julianvillarreal/CONVERTER-QBOOST/README.md

# CONVERTER-QBOOST

Implementación realizada en la IDE de arduino para se ejecutada en la tarjeta arduino Mega 2560
