julianvillarreal/CONVERTER-QBOOST/PCB/Sensado_V_I_QBoost_v0.1/Sensado_V_I_QBoost_v0.1.pdf

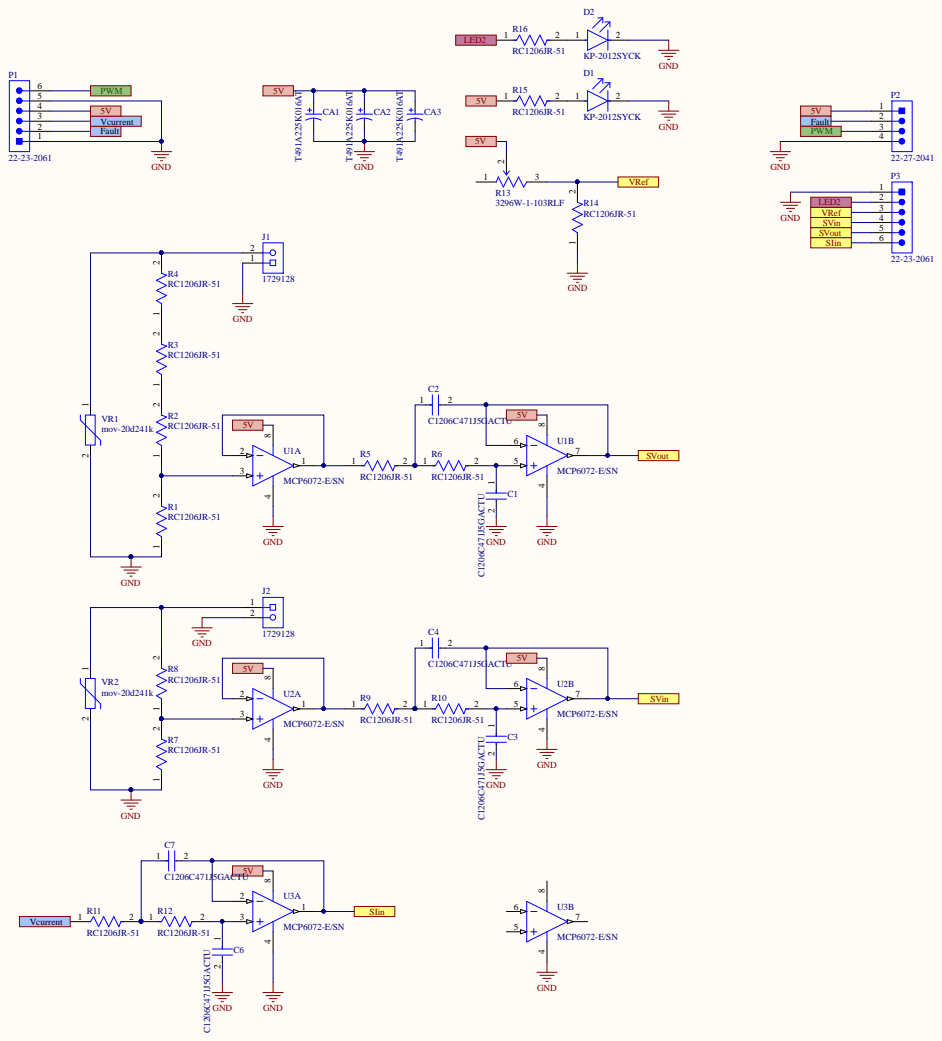
[picture p1: page 1]

Title | Protel International P/L L3, 12a Rodborough Rd NSW Frenchs Forest Australia 2086

Size: A1 | Number: | Revision:

Date: 17/10/2020 Time: 11:50:41 p. m. | | Sheet of

C:\Users\Julian\OneDrive - Pontificia Universidad Javeriana\10 semestre\PG2\PCB QBOOST\PCB 2 - Sensado\Sensado_Vin_Vou_Iin_0.1\Sensado_V_I_QBoost_v0.1\Sensado.SchDoc

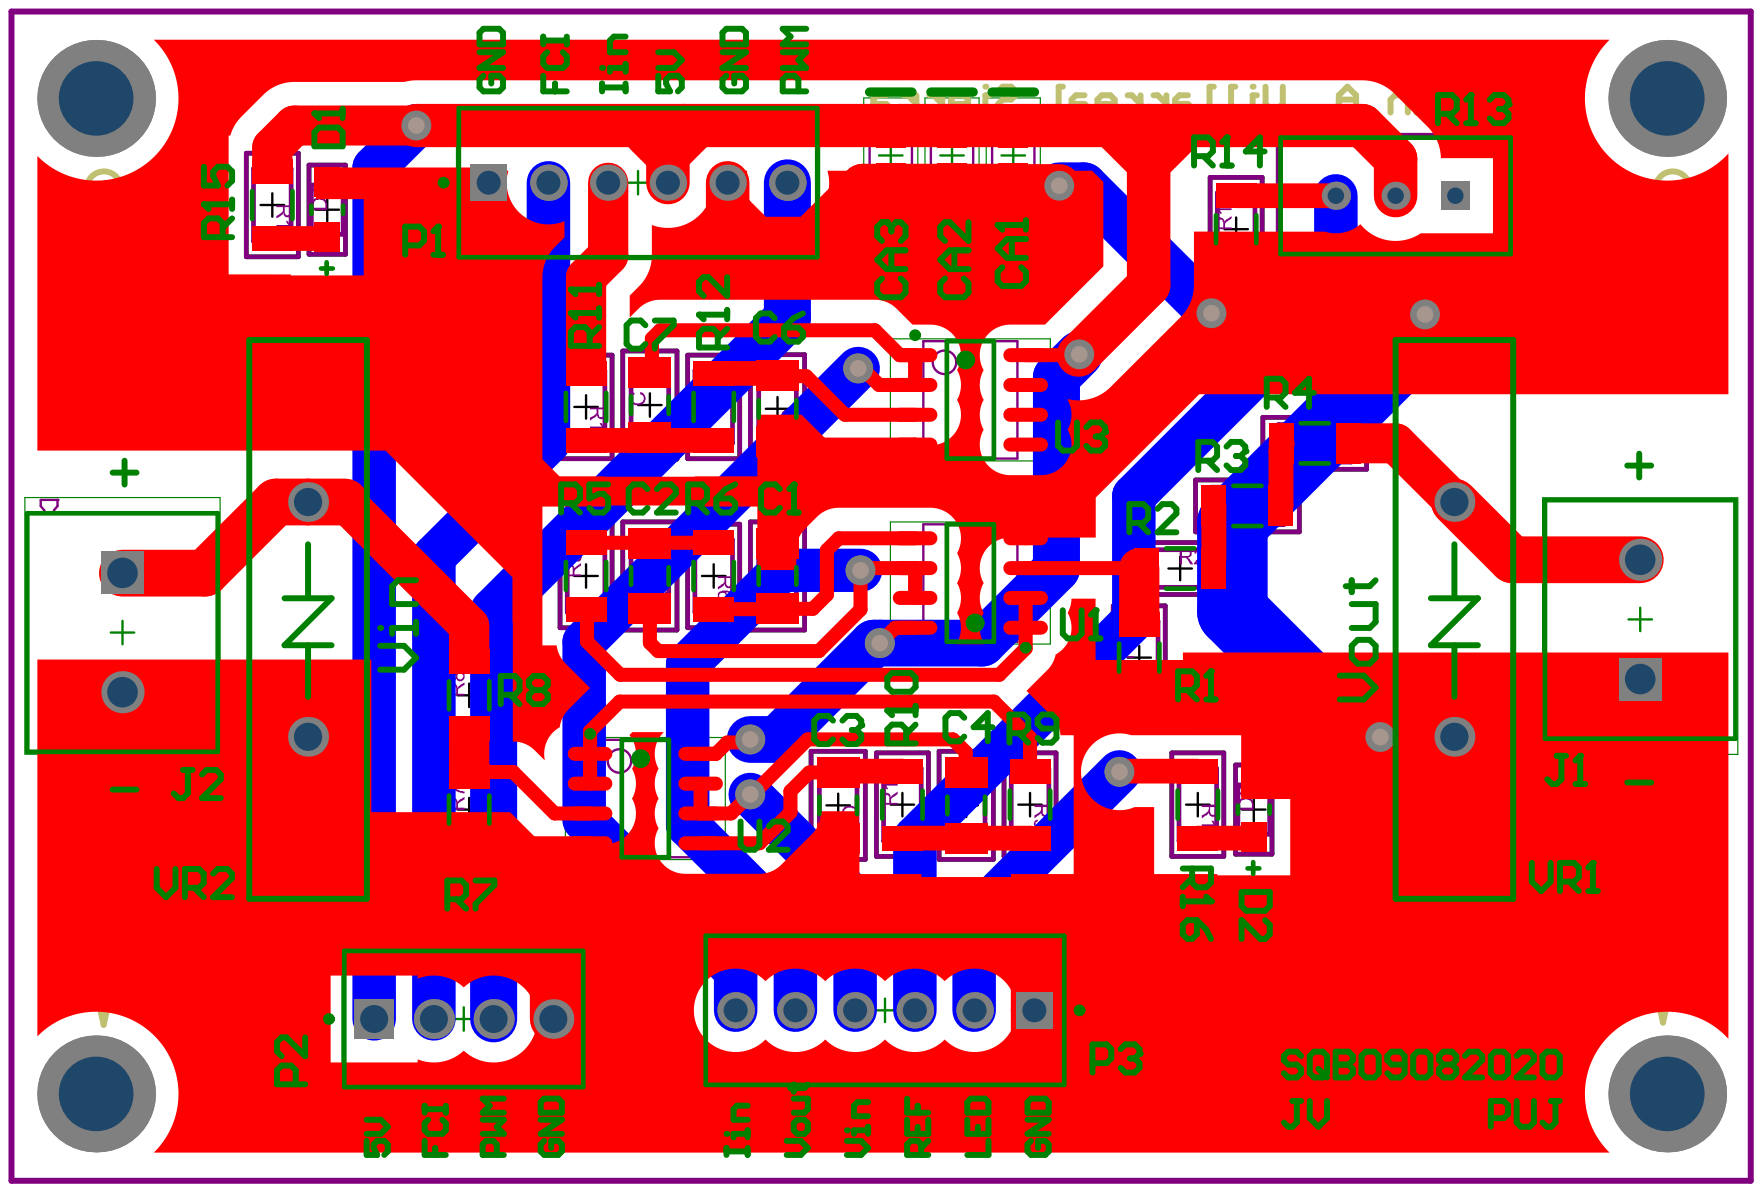
[picture p2: page 2]

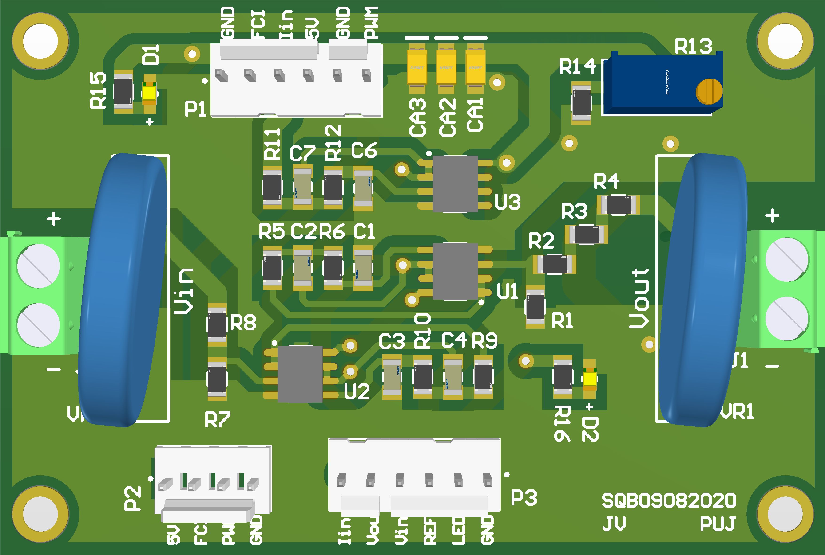
[picture p3: page 3]
