julianvillarreal/CONVERTER-QBOOST/PCB/Quadratic Boost v0.2/Quadratic Boost v0.2.pdf

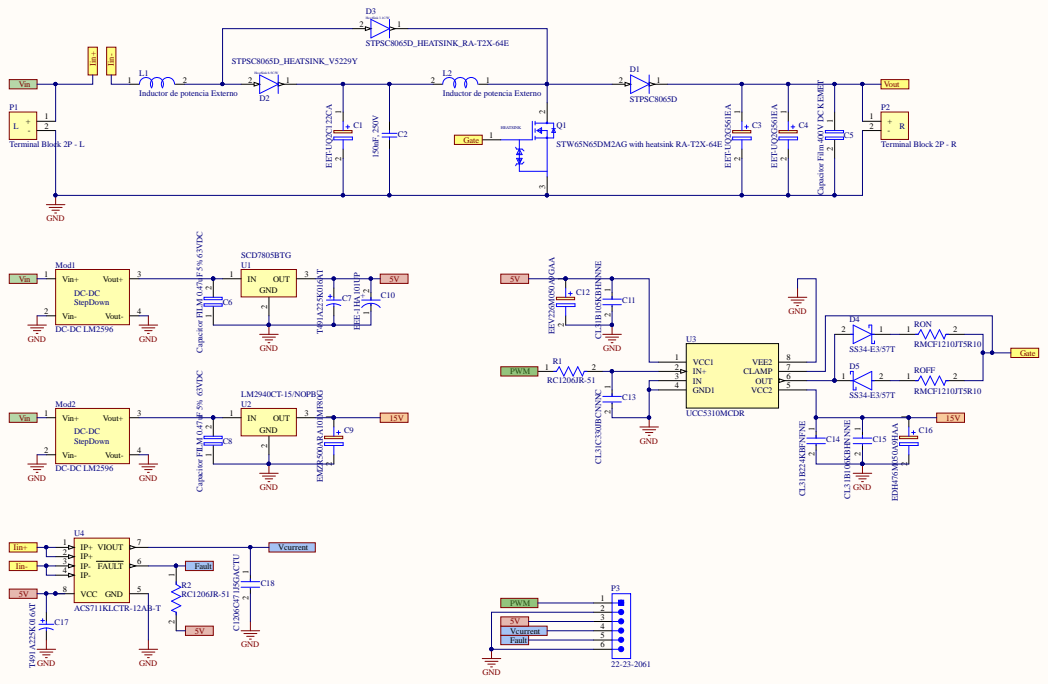
[picture p4: page 1]

Inductor de potencia Externo

Capacitor Film 400V DC KEMET

STW65N65DM2AG with heatsink RA-T2X-64E Gate

Vin+ 1 DC-DC StepDown Vin- 2 | 15V

Title | Protel International P/L L3, 12a Rodborough Rd NSW Frenchs Forest Australia 2086

Size: A1 | Number: | Revision:

Date: 17/10/2020 Time: 8:53:00 p. m. | | Sheet of

C:\Users\Julian\OneDrive - Pontificia Universidad Javeriana\10 semestre\PG2\PCB QBOOST\PCB 1 - Convertidor DC-DC\Quadratic Boost V0.2\Quadratic Boost v0.2\Sheet-QBOOST-v0.2.SchDoc

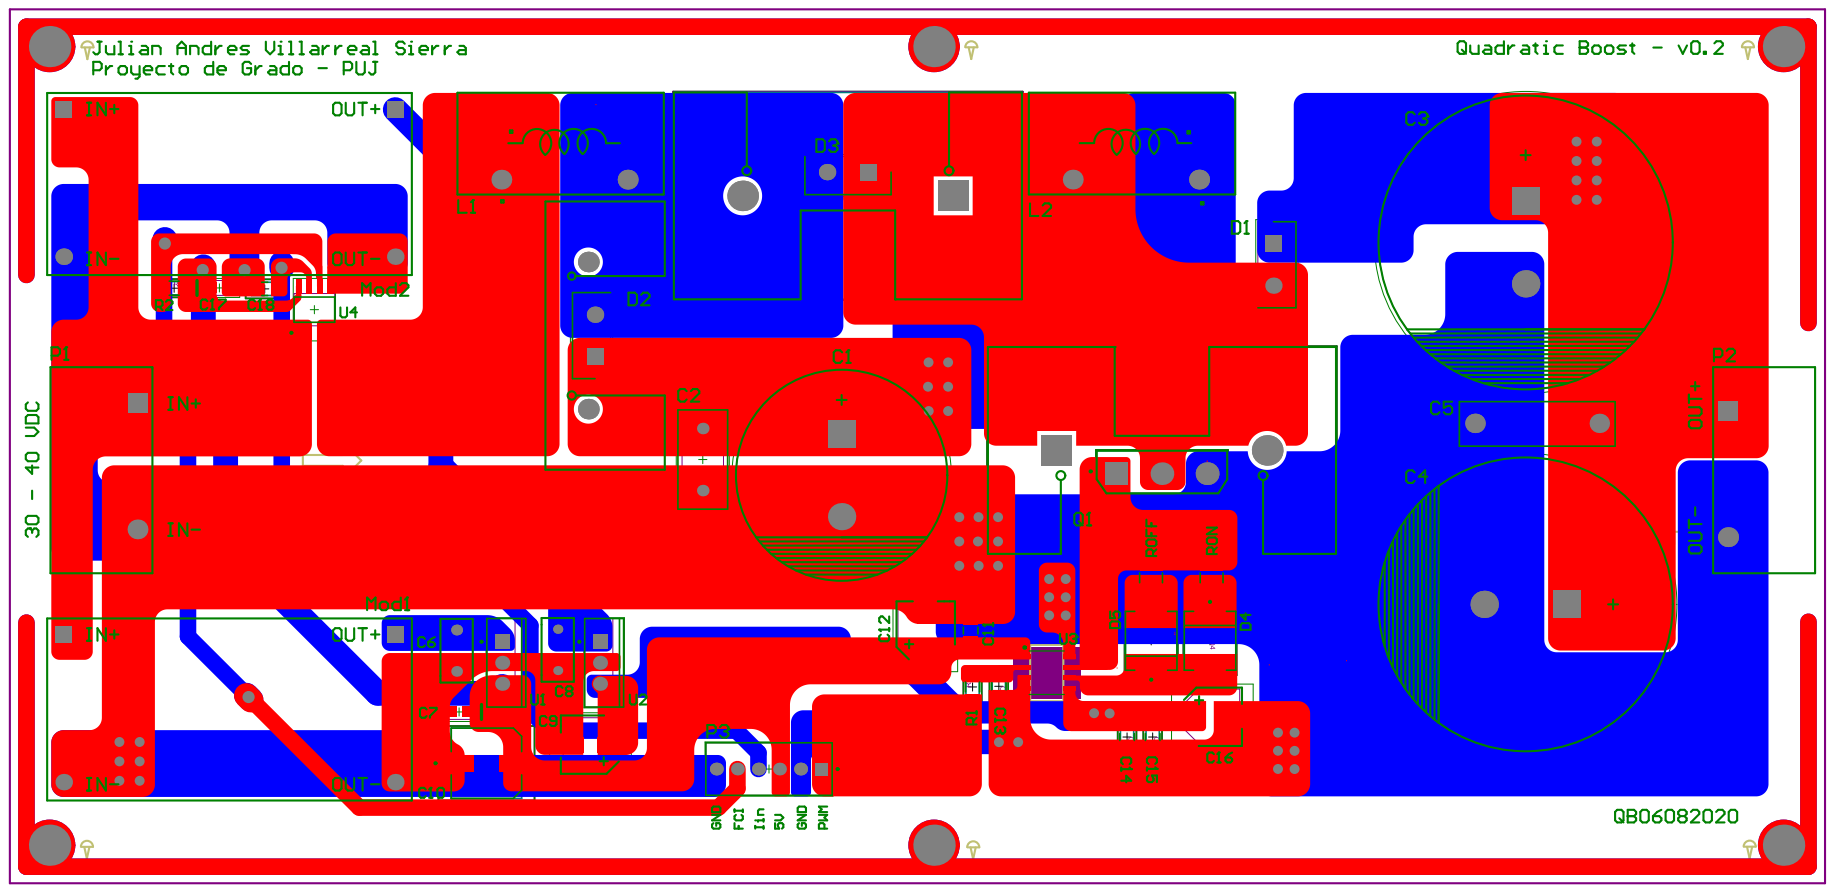
[picture p5: page 2]

Comment | Description | Designator | Footprint | LibRef | Quantity
EET-UQ2C122CA | Capacitor Polarised | C1 | CAPPRD1000W200D2EET-UQ2C122CA | 1
150nF, 250V | WCAP-FTBP Film CapC2 | WCA P-FTBP_L10.5W5890273322005CS | 1
EET-UQ2G561EA | Capacitor Polarised | C3, C4 | CAPPRD1000W200D3EET-UQ2G561EA | 2
Capacitor Film 400V DC KEMET | C5 | Cap Film 18x5 | Cap film 400V DC 0.1 | 1
Capacitor FILM 0.47uF 5% 63VDC | C6, C8 | Capacitor 5mm RadialCapacitor FILM 0.47 | 2
T491A225K016AT | Tantalum Capacitor, | C7,C17 | KEMT -T491-A_N | CMP-2000-07187-1 | 2
EMZR500ARA101MF8CAP ALUM 100UF 20%C9 | CAP6.3X8 | EMZR500ARA101 | 1
EEE-1HA101UP | CAP ALUM 100UF 20%C10 | FP-SF-MFG | CMP-05427-000015-1 | 1
CL31B105KBHNNNE | Cap Ceramic 1uF 50VC11 | FP-CL31-IPC_B | CMP-13271-001662-1 | 1
EEV226M050A9GAA | CAP ALUM SMD 105CC12 | CAP6.3X5.65 | EEV226M050A9GAA | 1
CL31C330JBCNNNC | Cap Ceramic 33pF 50C13 | FP-CL31-IPC_B | CMP-13271-000198-1 | 1
CL31B224KBFNFNE | Cap Ceramic 220nF 5C14 | FP-CL31-IPC_B | CMP-13271-000776-1 | 1
CL31B106KBHNNNE | CAP CER 10UF 50V X7C1 5 | FP-CL31-IPC_B | CMP-13271-000776-1 | 1
EDH476M050A9HAA | CAP ALUM SMD 105CC16 | CAP6.3X8 | EDH476M050A9HAA | 1
C1206C471J5GACTU | 1206 C 470pF CeramicC 18 | FP -C1206C-EB-IPC_BC MP -03020-008367-1 | 1
STPSC8065D | Diode | D1 | TO505P460X1020X19STPSC8065D | 1
STPSC8065D_HEATS Diode withheatsink VD | TO505P460X1020X19STPSC8065D_HEAT | 1
STPSC8065D_HEATS Diode withheats ink RAD3 | TO505P460X1020X19STPSC8065D_HEAT | 1
SS34-E3/57T | DIODE SCHOTTKY 40D4,D5 | FP-95402-MFG | CMP-02539-000012-1 | 2
Inductor de potencia Externo | L1, L2 | KF7.62-P3 | Inductor | 2
DC-DC LM2596 | LM2596HV DC-DC AdjuMo d1, Mo d2 | Mod21x43 mm | DC-DC LM2596 | 2
Terminal Block 2P - LBornera con
| | P1 | KF7.62-P2 - TB - L | Terminal Block 2P - L | 1
Terminal Block 2P - RBornera con
P2 | KF7.62-P2 - TB - R | Terminal Block 2P - R | 1

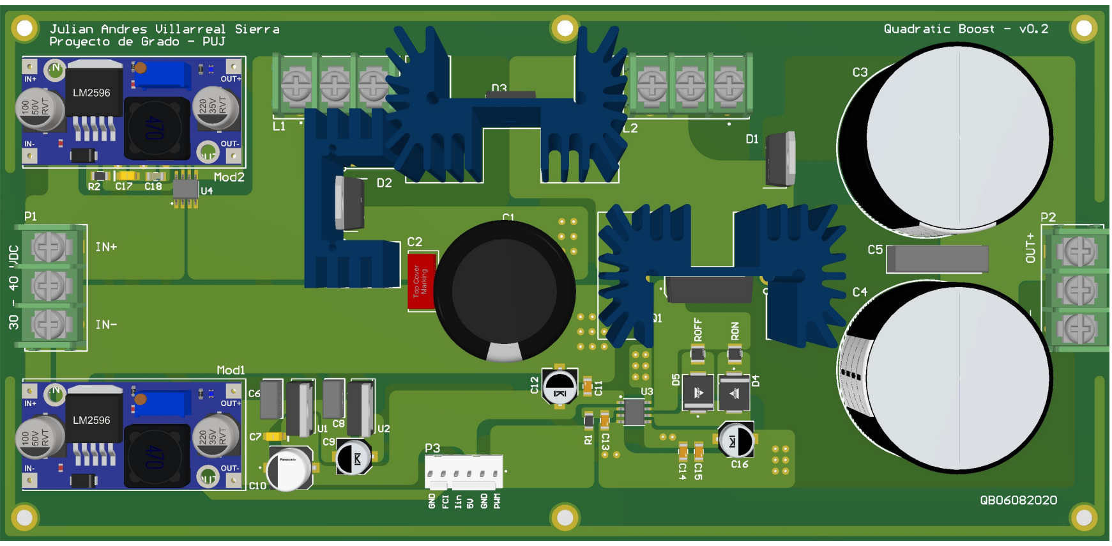
[picture p6: page 4]
