julianvillarreal/CONVERTER-QBOOST/PCB/Quadratic Boost v0.2/Sheet-QBOOST-v0.2.pdf

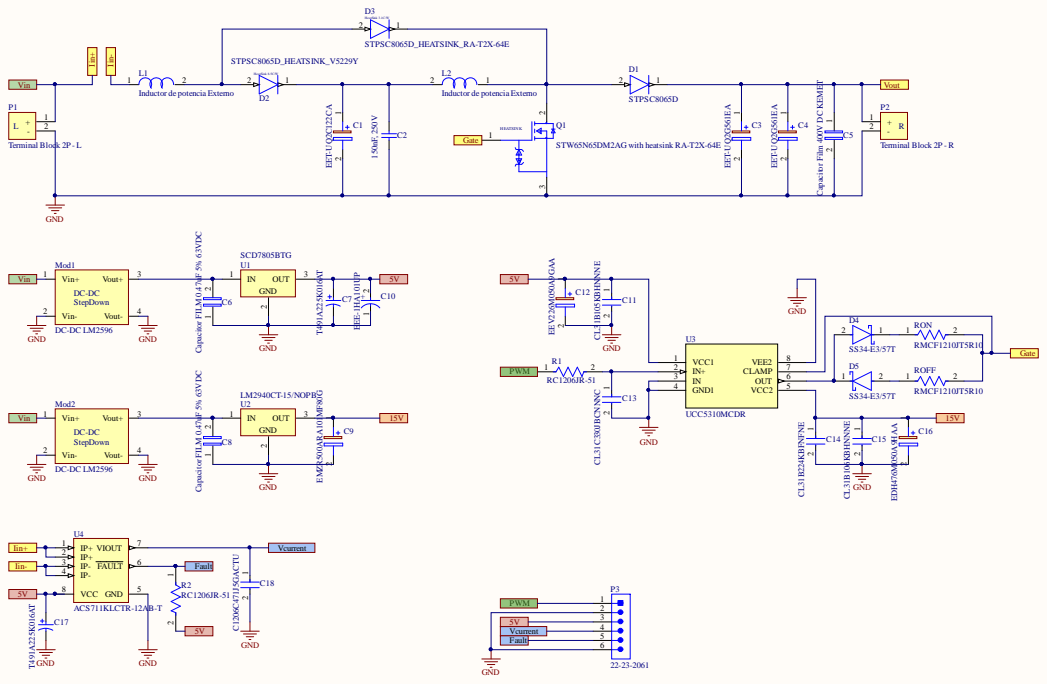
[picture p7: page 1]

Inductor de potencia Externo

Capacitor Film 400V DC KEMET

STW65N65DM2AG with heatsink RA-T2X-64E Gate

Vin+ 1 DC-DC StepDown Vin- 2 | 15V

Title | Protel International P/L L3, 12a Rodborough Rd NSW Frenchs Forest Australia 2086

Size: A1 | Number: | Revision:

Date: 21/08/2020 Time: 12:33:43 p. m. | | Sheet of

C:\Users\Julian\OneDrive - Pontificia Universidad Javeriana\10 semestre\PG2\PCB QBOOST\PCB 1 - Convertidor DC-DC\QuadraticBoost V0.2\QuadraticBoost v0.2\Sheet-QBOOST-v0.2.SchDoc

Comment | Description | Designator | Footprint | LibRef | Quantity
