julianvillarreal/CONVERTER-QBOOST/(list of files, drawings)

Other design files:
PCB/Quadratic Boost v0.2/QBOOST-v0.2 - copia.PcbDoc
PCB/Quadratic Boost v0.2/Quadratic Boost v0.2.PrjPcb
PCB/Quadratic Boost v0.2/Sheet-QBOOST-v0.2.SchDoc
PCB/Sensado_V_I_QBoost_v0.1/Sensado.PcbDoc
PCB/Sensado_V_I_QBoost_v0.1/Sensado.SchDoc
PCB/Sensado_V_I_QBoost_v0.1/Sensado_V_I_QBoost_v0.1.PrjPcb
