julianvillarreal/CONVERTER-QBOOST/(commit log)

2021-08-08 Version 1 control QBOOST MPPT-BASICO - Version presentada en el T.G.
2021-08-08 Version 1 control QBOOST MPPT-BASICO - Version presentada en el T.G. - CODIGO
2021-08-08 PCB convertidor V2
    [QBOOST-v0.2 - copia.PcbDoc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]
2021-08-08 PCB sensado para el convertidor QBOOST
    [Sensado.DRL, Sensado.GBL, Sensado.GBO, Sensado.GBS, Sensado.GM1, Sensado.GTL, Sensado.GTO, Sensado.GTP]
